grilldoo/diy-launch-monitor/docs/design.md

# Design

A battery-powered, photometric (camera-based) launch monitor in the style of the
Foresight GC3 / GCQuad. It sits beside the ball, photographs the last few
centimetres of club travel and the first ~30 cm of ball flight, and needs no
in-bay calibration, so it can be set up anywhere: hitting mat, garage, range.

Radar units (Trackman-style) were rejected because indoors they need a long
flight and placement calibration. Cameras only need to see the impact zone.

## Coordinate system and sign conventions

Origin at the ball centre at address. `+x` toward the target, `+y` up, `+z`
away from a right-handed golfer (toward the unit). Internally everything is SI
(m, s, rad); results are reported in golf units.

| Quantity | Positive means |
|---|---|
| HLA (horizontal launch) | right of target |
| VLA (vertical launch) | up |
| Sidespin / spin axis | curves right (fade/slice for a right-hander) |
| Club path | in-to-out (right) |
| Face to target | open (right) |
| Attack angle | up |
| Face to path | face - path |

## Layout

```
                 target (+x) -->
   golfer (RH)        o ball
   -z side     [gate2]  [gate1] are spots on the mat 18 and 30 cm behind the ball
                          \
                           \  ~60-70 cm
                            [ UNIT ]  +z side, ~35 cm forward of the ball,
                                       yawed back toward the impact zone
```

The unit sits forward of the ball and looks back diagonally so the cameras can see
the club-face stickers at an angle. (From straight side-on, the face is edge-on.)
Placement constants live in `src/launchmonitor/rig.py`; `tests/test_rig.py`
checks that every club and ball position the solver needs is in frame.

## Hardware architecture

```
 12 V Li-ion pack (BMS) -+-- 5V/5A buck --> Raspberry Pi 5 (4GB)  [+ 2nd Pi 5 in stage 2]
                        +-- 12V rail + capacitor bank --> LED driver --> 12x 850 nm IR LEDs
 Pi 5
  |- CSI0/CSI1 --> InnoMaker IMX296 mono global-shutter cameras, 850 nm bandpass filters
  |- USB ------> Pico 2: gates in, camera triggers + strobe out (microsecond timing)
  |- SPI ------> ADXL355 accelerometer (automatic level)
  `- Wi-Fi ----> GSPro (Open Connect, TCP 921) / phone web page
```

### Stages
* **Stage 1, 2 cameras:** one stereo pair (6 mm lenses, 20 cm baseline) sees club and ball.
* **Stage 2, 4 cameras (GCQuad-style):** add a second Pi 5 and a dedicated club pair
  (12 mm lenses, tighter view of the last 10 cm before impact). The Pico already has four
  camera trigger outputs, so all four cameras are hardware-synchronised.

### Why a strobe instead of a high-speed camera
The cameras are 60 fps global-shutter sensors (about $50). One exposure stays open for
~3-6 ms while the IR LEDs flash 15 µs pulses. Every flash freezes the ball and club
(80 m/s x 15 µs = 1.2 mm blur), so one frame holds the whole sequence.

## Timing (firmware/pico/src/lm_timing.c, mirrored in schedule.py)

1. **Club gates.** Two retro-reflective optical gates (IR emitter + photodiode in the unit,
   aimed at small retro-reflective dots on the mat at 30 cm and 18 cm behind the ball). The
   clubhead breaks each return beam in turn.
2. **Club speed and impact time** come from the gate-to-gate time. Impact is predicted
   assuming constant speed over the last 18 cm.
3. **Flash plan:**
   * 3 club flashes, when the face is 13, 7.5 and 2 cm from the ball. They're ~5.5 cm apart so
     the sticker images don't overlap in either camera, which sees them at a steep angle (even
     so, slow wedge swings can make two touch: the detector splits them). Face angle and loft
     come from the last one (the face is still closing before that). Path, attack angle and club
     speed come from all three.
   * 5 ball flashes, spaced so the ball moves about 6 cm (1.4 diameters) between them, based on
     *expected* ball speed (1.35 x club speed). Ball images never overlap, even at a smash
     factor of 1.15 (`tests/test_rig.py`).
   * Too-fast swings drop the earliest club flash rather than miss the shot.
4. **Exposure** opens 50 µs before the first flash and closes 50 µs after the last.
5. The Pico prints the actual schedule as JSON. The solver uses those times, so the
   impact-prediction error only shifts flash timing; it doesn't corrupt the measurement.

### Cameras and trigger
The cameras are **InnoMaker CAM-IMX296Mono-GS** boards: the same Sony IMX296 global-shutter
sensor as the official Pi GS camera, and the same Raspberry Pi kernel driver. The differences
that matter here:
* **Mono sensor with no IR-cut filter.** The official GS camera is colour with a fixed IR-cut
  filter, which blocks the 850 nm strobe.
* **Opto-isolated hardware trigger on a pin header (J3).** No board modification, unlike the
  official camera's XTR pad. Wiring is in docs/wiring.md.
* M12 lens mount (a CS seat is included). Lenses must not have an IR-cut filter.

The trigger opto adds a turn-off delay of up to tens of microseconds at exposure start, and it
varies between units. The schedule opens the exposure 300 µs before the first flash
(`exposure_lead_us`). The flashes, not the exposure edges, define when each image is taken, so
that delay doesn't affect the measurement. The first club flash comes 5 cm after gate 2, so it
fits at every club speed up to the 75 m/s (168 mph) limit.

## Optics and lighting
* IMX296: 1456 x 1088, 3.45 µm pixels. With a 6 mm M12 lens at ~65 cm the view is about 55 cm
  wide at 0.37 mm/px. A ball is about 115 px across.
* 850 nm bandpass filters reject most indoor light. Gate emitters are 940 nm, so the cameras
  don't see them.
* Outdoor kit (phase 6): swap to 940 nm LEDs and filters (the atmosphere absorbs some sunlight
  at 940 nm), add a sun hood and drive the LEDs harder. Gate emitters move to 850 nm with
  modulation.

## Markings
* **Ball:** 30 dots of 3.5 mm in an irregular pattern (`src/launchmonitor/data/ball_pattern.json`),
  applied with the 3D-printed jig (`cad/ball_jig.scad`) so every ball is identical. The pattern
  was chosen by `tools/make_ball_pattern.py`: of 12 random well-spaced candidates, it's the one
  whose orientation is recovered most reliably from only the dots two cameras can see (300 of
  300 trials). Dots stay 7° clear of the jig's seam. **Treat the pattern as fixed once balls are
  marked:** regenerating it makes every marked ball useless.
* **Ink:** must absorb IR. Use carbon-pigment ink (e.g. Sakura Pigma Micron). Many Sharpie inks
  are invisible at 850 nm, so test under the strobe first.
* **Club:** a 32 x 28.5 mm sticker with five 5 mm dots (`src/launchmonitor/markers.py`), on the
  face near the toe. The layout was searched so that no wrong labelling of the dots fits it
  under any stretch or skew the oblique camera view produces, with all dots or any one missing.
  The best wrong fit is 1.2 mm off. Distinct dot-to-dot distances alone weren't enough: an early
  layout had a re-ordering that fitted to 0.1 mm once stretched. Clubs **must** be marked for
  face angle and loft. Path and club speed need the sticker too, the way this detector works.

## Club detection (src/launchmonitor/detect.py)
Each frame holds the sticker three times before impact, plus more images after impact (the club
keeps moving and the ball flashes light it), some overlapping the ball images. Per camera:
1. **Balls first, robust to overlaps:** a distance transform finds each ball's centre (only a
   ball is that thick), and the circle is refitted on its own outline, ignoring attached sticker
   edges. The resting ball is the biggest saturated disk (every flash lit it). Moving-ball
   images are given flash numbers from their spacing, so a hidden image shows as a double gap
   instead of shifting the rest. Inconsistent spacing means that camera's ball data is dropped.
2. **Stickers:** bright regions left after masking the balls, containing 4-6 dark dots. Touching
   sticker images are split by clustering their dots.
3. **Which flash:** stickers *behind* the resting ball (opposite to the ball's flight) are the
   club before impact, nearest the ball = last club flash. The rest are ignored.
4. **Which dot:** every assignment is fitted with an affine map. Mirror images are skipped (the
   cameras only ever see the front), and the best fit must clearly beat the runner-up, or the
   sticker is dropped.
5. **3D check:** the triangulated dots must match the printed layout within 1.5 mm, or face
   angle and loft are not reported.

Over 90 random rendered shots (driver to wedge), no sticker was mislabelled. Club speed came
out within 0.05 mph rms, path 0.04°, attack 0.01°, face 0.25°, loft 0.25° (`tests/test_club.py`).
These are rendered frames without real-world glare, specular club heads or worn stickers, so
real numbers will be worse. The table below models detection noise.

## Ball-dot matching (src/launchmonitor/dots.py)
Image detection (`detect.detect_shot`) finds ball images and dark dots but doesn't know which
dot is which. For each ball flash:
1. Back-project every dot onto the ball sphere (centre triangulated from the ball images, known
   radius). This works from one camera, so dots only one camera sees still count.
2. Merge points from both cameras that land within 1.5 mm of each other.
3. Find the rotation of the known pattern that explains the points. A coarse search over 12,000
   rotations is followed by ICP on the best 8. The score also penalises pattern dots that face
   the cameras squarely but weren't detected, which removes look-alike orientations.
4. Give each detection the id of the nearest rotated pattern dot (within 8°).

On rendered frames (driver and wedge, pixels in), every dot was labelled correctly, and spin came
out within about 1% (`tests/test_dots.py`). It takes about 0.1-0.3 s per flash in Python on a
laptop; the Pi 5 will be slower. Vectorising or porting the coarse search is the obvious speed-up.

## Solver (src/launchmonitor/solver.py)
1. Triangulate every detection seen by 2 or more cameras in the same flash (N-view DLT).
2. Ball: straight-line fit of centres vs. flash time gives speed, VLA and HLA.
3. Spin: Kabsch rotation of the ball dots between consecutive flashes gives angular velocity.
   That is split into backspin and sidespin around the launch direction.
4. Club: fit the known sticker layout in the last pre-impact flash for face and loft. A line fit
   of the sticker centroid over the club flashes gives speed, path and attack angle.
5. Ball flight model (`flight.py`) gives carry for the stand-alone readout. GSPro does its own.

## Simulated accuracy (detection noise only)

`python tools/accuracy_study.py --seeds 200`, 0.15 px detection noise, 1 sigma:

| Shot | Rig | Ball mph | VLA | HLA | Spin % | Axis | Club mph | Path | Attack | Face | Loft |
|---|---|---|---|---|---|---|---|---|---|---|---|
| driver | 2-camera | 0.08 | 0.01 | 0.06 | 0.35 | 0.41 | 0.14 | 0.09 | 0.02 | 0.62 | 0.68 |
| driver | 4-camera | 0.08 | 0.01 | 0.06 | 0.35 | 0.41 | 0.04 | 0.03 | 0.01 | 0.20 | 0.23 |
| 7-iron | 2-camera | 0.06 | 0.01 | 0.07 | 0.11 | 0.13 | 0.09 | 0.09 | 0.02 | 0.59 | 0.63 |
| 7-iron | 4-camera | 0.06 | 0.01 | 0.07 | 0.11 | 0.13 | 0.03 | 0.03 | 0.01 | 0.21 | 0.22 |
| wedge | 2-camera | 0.05 | 0.02 | 0.09 | 0.14 | 0.13 | 0.09 | 0.09 | 0.02 | 0.71 | 0.64 |
| wedge | 4-camera | 0.05 | 0.02 | 0.09 | 0.14 | 0.13 | 0.03 | 0.03 | 0.01 | 0.27 | 0.24 |

These are lower bounds. Real error will be higher, mostly from calibration, lens distortion,
detection bias and timing jitter, none of which are modelled yet.
What the table does show: **the dedicated club pair cuts face and loft error about 3x.** Ball
data doesn't change, since stage 2 doesn't touch the ball cameras.

## Calibration and setup (src/launchmonitor/calibration.py)

**Once, at build time** (ChArUco board; details in docs/pi-setup.md). Everything rigid is
stored relative to the unit itself (camera A's frame):
1. Lens intrinsics and distortion, and camera B relative to camera A: the board waved in front.
2. **Reference edge:** one straight edge of the enclosure (with sight notches) defines "aim".
   The board stands upright, parallel to that edge, and the software records which way the edge
   points in camera coordinates.
3. **IMU alignment:** with the board left in place, the unit is tilted on shims 4 ways and the
   accelerometer read each time. A rotation fit (Kabsch) maps IMU axes to camera axes, and also
   absorbs the accelerometer's constant offset over the range of tilts captured.

**Every setup, no board:**
1. Place the unit about 60 cm from the ball (the resting ball only needs to be in view; its
   position is measured each shot, not assumed).
2. Line the reference edge up with the target line (an alignment stick against it, or sight down
   the notches). Indoors: square it to the screen.
3. Turn it on. The IMU gives "up"; aim is the edge's direction projected onto the level plane, so
   a sloping mat doesn't change the aim. The level is re-read every few seconds while idle, so a
   bumped unit corrects itself, and each saved shot records the level and aim it used.

Simulated (tests/test_calibration.py): with a deliberately crooked IMU mount (~30°), 0.006 g
offset and realistic noise, the level + aim frame came out within 0.05° on average (0.11° worst)
over 30 random setups tilted up to ±5°. Real-world aim accuracy will be dominated by how
carefully the edge is lined up: typically ±0.5-1°, the same as a GC3/GCQuad.

The simulation doesn't model the accelerometer's zero point drifting with temperature. That's
why the level sensor is an ADXL355 (0.15 mg/°C max, so under 0.2° over a 20 °C swing) rather
than a consumer IMU like the ICM-42688-P (up to ±1 mg/°C, so up to ~1°).

**Camera-agreement check:** every shot, the ball centres from both cameras are triangulated and
reprojected. A median error above 1.5 px adds a "re-run the calibration" warning. A camera
knocked by 0.4° trips it; a healthy rig reads well under 1 px. It can't see movement that keeps
the views consistent (along the epipolar lines), but catches most bumps.

`calib reaim` (board upright on the mat at the target line) remains as an optional precise aim
(`run --aim board`).

## Known risks / open questions
* **Dot matching on real images:** solved on simulated frames (above). Still unproven against
  real dimples, scuffs, logos, uneven hand-marked dots, and printed-jig tolerances. If the
  ball's logo shows up as false dots, raise the dot-size filter or mark balls with the logo
  under the jig's solid area. UNVERIFIED on hardware.
* **High-spin aliasing:** wedges at 10,000 rpm turn about 90° between flashes. That's fine, but
  close to the 180° limit at low ball speed. Could add one extra closely spaced flash pair.
* **Club and ball overlap at impact:** the last club flash is 2 cm before contact. Check on
  real frames that stickers aren't hidden by the ball (the simulator ray-tests this).
* **Driver/wood face curvature:** woods have a curved face (bulge), so a sticker on the toe side
  sits on a part of the face that points a few degrees more open than the centre (~3-4° on a
  driver). Irons are flat. Needs a per-club face-angle offset (a "club profile"), not yet built.
* **Shiny club heads:** a chrome head can throw bright specular glints. They have no dot pattern,
  so they shouldn't pass as stickers, but they could merge with a sticker image. UNVERIFIED.
* **Face closure:** the face keeps closing (roughly 0.5-1° at typical closure rates) between the last flash and impact. Correct it
  by extrapolating the face rotation from the three club flashes.
* **GSPro sign conventions:** verify on first hookup.
