grilldoo/diy-launch-monitor/cad/stl/camera_mount_ballA.stl

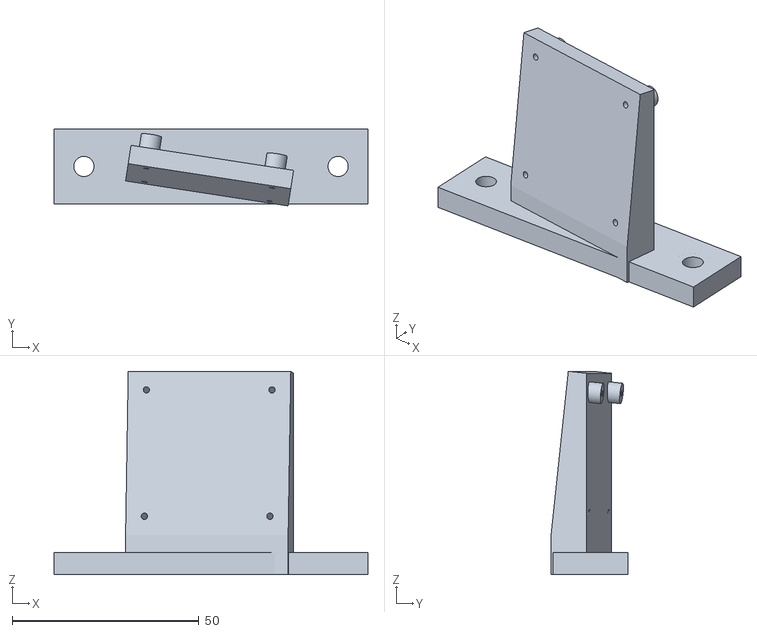
[picture p1: CAD file, 2026-10-27]
cad/stl/camera_mount_ballA.stl
84.0 x 20.6 x 54.4
