grilldoo/diy-launch-monitor/cad/stl/camera_mount_clubB.stl

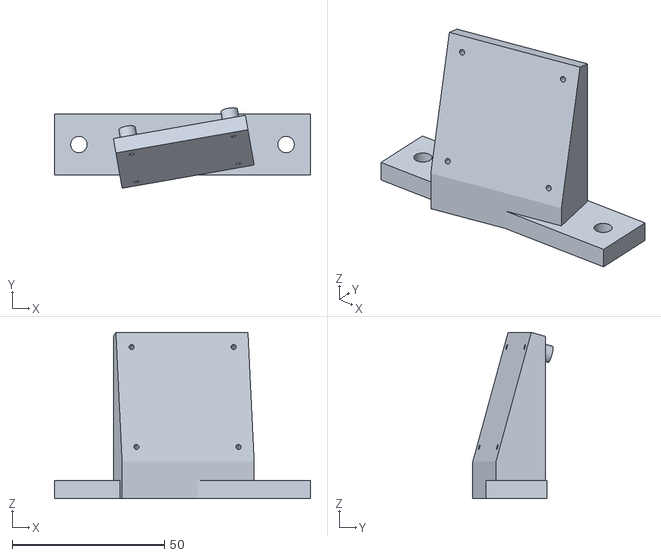
[picture p2: CAD file, 2026-10-27]
cad/stl/camera_mount_clubB.stl
84.0 x 26.4 x 54.5
