grilldoo/diy-launch-monitor/cad/stl/ball_jig_both_halves.stl

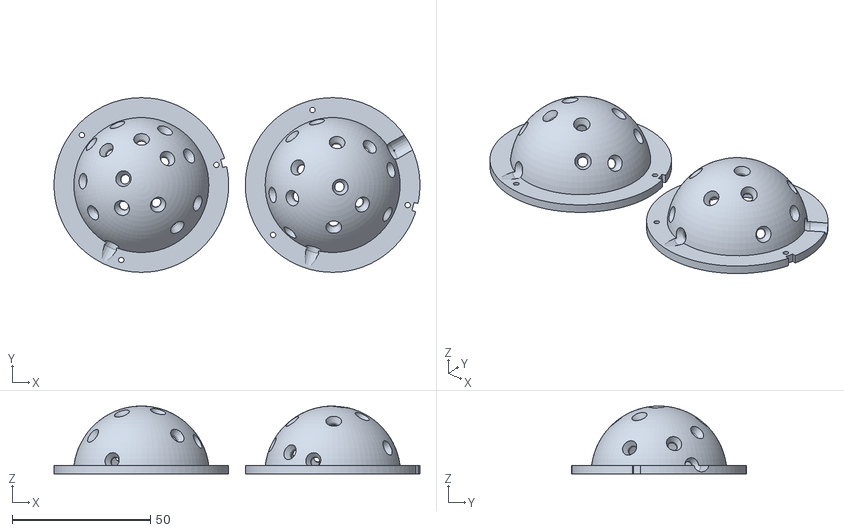
[picture p3: CAD file, 2026-10-26]
cad/stl/ball_jig_both_halves.stl
132.3 x 63.2 x 24.6
