grilldoo/diy-launch-monitor/cad/generated/ball_pattern.scad

// GENERATED by tools/export_cad.py - do not edit.
dot_diameter_mm = 3.5;
dots = [
  [0.003034, 0.676107, 0.736797],
  [-0.632398, 0.704156, -0.322856],
  [-0.715365, -0.411466, 0.564755],
  [0.112517, 0.031223, -0.993159],
  [0.439768, 0.289435, -0.850195],
  [-0.518673, 0.517838, 0.680310],
  [-0.287041, -0.341091, 0.895134],
  [-0.265278, 0.093471, 0.959631],
  [0.387106, 0.391987, 0.834563],
  [-0.888963, 0.146910, -0.433777],
  [-0.354678, 0.889289, 0.288736],
  [0.813491, 0.434916, -0.386109],
  [-0.234277, -0.932909, -0.273487],
  [-0.738997, 0.606211, 0.293926],
  [0.549815, -0.565982, -0.614303],
  [0.065977, -0.629361, -0.774307],
  [0.016566, 0.624239, -0.781058],
  [-0.599529, -0.719334, -0.350890],
  [-0.518569, -0.260606, -0.814353],
  [-0.865394, 0.057665, 0.497764],
  [0.833241, -0.270970, 0.481960],
  [0.865297, -0.485169, -0.125982],
  [0.532882, -0.628310, 0.566801],
  [0.707892, 0.431431, 0.559246],
  [-0.286326, 0.936851, -0.200819],
  [-0.433154, -0.878638, 0.200932],
  [0.248546, -0.292207, 0.923493],
  [0.864693, -0.223056, -0.450057],
  [-0.597028, 0.194788, -0.778213],
  [0.350280, 0.807965, 0.473810]
];
