grilldoo/diy-launch-monitor/cad/generated/rig_angles.scad

// GENERATED by tools/export_cad.py - do not edit.
// [name, yaw_deg (+ = counter-clockwise seen from above), pitch_deg (+ = up)]
// Mount the two cameras of a pair 200 mm apart (lens centre to lens centre).
cams = [
  ["ballA", -8.75, -6.08],
  ["ballB", 8.75, -6.08],
  ["clubA", -9.98, -15.50],
  ["clubB", 9.98, -15.50]
];
