grilldoo/diy-launch-monitor/(list of files, cad)

Other CAD files:
cad/stl/camera_mount_ballB.stl
cad/stl/camera_mount_clubA.stl
