grilldoo/diy-launch-monitor/docs/printing.md

# 3D printing (Bambu A1 Mini)

Ready-to-print files are in [`cad/stl/`](../cad/stl). They are generated from the OpenSCAD
sources in `cad/` by `python tools/export_cad.py`, using the same ball pattern, rig geometry and
club-marker layout that the solver assumes. Don't edit the STLs by hand: change the `.scad`
parameters or the Python geometry, then re-export. (Claude Code can do this for you.)

Filament: **PETG** for everything. It's stiffer under warmth than PLA and doesn't need an
enclosure like ASA. Defaults are fine unless noted.

| File | Qty | Stage | Settings |
|---|---|---|---|
| `ball_jig_both_halves.stl` | 1 | now | 0.12-0.16 mm layers, 3 walls, flange down, no supports |
| `camera_mount_ballA.stl`, `camera_mount_ballB.stl` | 1 each | 1 | 0.2 mm, 4 walls, 40% infill, foot down, no supports |
| `camera_mount_clubA.stl`, `camera_mount_clubB.stl` | 1 each | 2 | as above |
| `../club_markers.svg` | sheet | 1 | paper, not 3D: print at 100% on matte white sticker paper |

The enclosure and battery box come later, once the boards and pack are in hand to measure.
The enclosure will have a straight **reference edge** with a sight notch at each end: lining
that edge up with the target line is how the unit is aimed at each setup (docs/design.md).

## Ball-marking jig

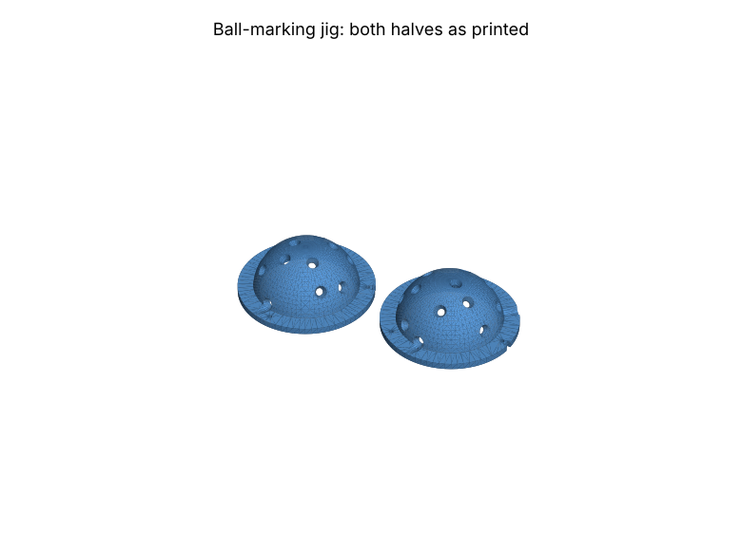
[picture p4: docs/images/ball_jig.png]
Ball-marking jig


Two half-shells with a countersunk hole at every pattern dot (30 dots, 3.5 mm).

1. **Test the fit first.** The ball should drop in snugly and not turn once the halves are closed.
   If it's loose or won't close, change `clearance` in `cad/ball_jig.scad` (default 0.25 mm,
   radial) and re-export.
2. **Pins:** cut three ~6 mm pieces of 1.75 mm filament. The three pin holes are unevenly
   spaced, so the halves only line up one way. The notches on the flange edges should line up
   too. If PETG prints the holes tight, open them with a 2 mm drill bit by hand.
3. Close the jig around a clean ball. Turn the ball so its logo sits under solid shell, not a
   hole, before closing.
4. Mark through every hole with a **Sakura Pigma Micron 05 (or 08)**: a firm, circular motion
   fills the 3.5 mm hole. Do all 30 dots (15 per half) without opening the jig.
5. Let it dry for a minute before opening.
6. **IR check (once you have the camera and LEDs):** the dots must look black under 850 nm. If
   they fade, switch pens.

Every ball must use **this exact pattern**. `src/launchmonitor/data/ball_pattern.json` is now
fixed, so don't regenerate it.

## Camera mounts

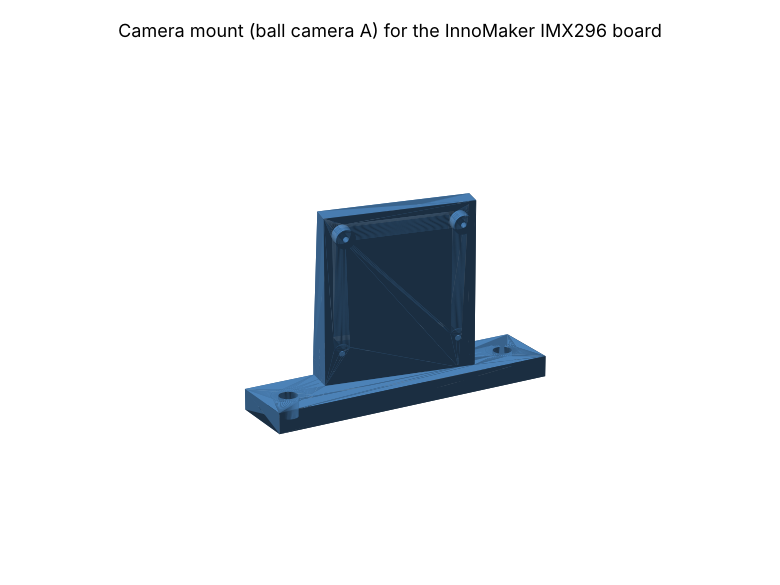
[picture p5: docs/images/camera_mount.png]
Camera mount


* For the **InnoMaker CAM-IMX296Mono-GS** board: 39 x 39 mm, four holes on a 34 mm square.
* Bolts to the top of a 2020 extrusion with 2x M5x10 screws and 2020 T-nuts. The screws sit
  outside the plate, so you can reach them with the camera fitted.
* The board screws onto the four bosses with **4x M2x8 self-tapping screws**, lens facing away
  from the plate. The bosses hold the board 4 mm off the plate to clear the parts on its back.
  Put the 15-pin ribbon connector at the top.
* Pre-angled from the rig geometry:

  | Mount | Yaw (toe-in) | Pitch |
  |---|---|---|
  | ballA / ballB | -8.7° / +8.7° | -6.1° (down) |
  | clubA / clubB | -10.0° / +10.0° | -15.5° (down) |

* Space the two cameras of a pair **200 mm apart** (lens centre to lens centre). Camera A is
  the left one when you stand behind the unit facing the ball.
* Stereo calibration measures the exact pose, so a degree or so of error is fine. Once
  calibrated, the cameras must not move: add a drop of medium thread-locker on the M5s.
* UNVERIFIED: InnoMaker's manual doesn't give the board's hole diameter (M2 fits either M2 or
  M2.5 holes). Hold a board against the print before printing the second one.
* The 850 nm filter cap that fits over the M12 lens comes later, once the lens is in hand to
  measure.

## Club markers

Every club you want club data from needs one. `cad/club_markers.svg` has 16 stickers
(32 x 28.5 mm, five 5 mm dots). Print at 100% on matte white sticker paper and check the
50 mm bar.

* Stick it **flat on the face, on the toe side**, arrow toward the toe, inner edge about 3.5 mm
  toe-side of the face centre (the middle of the grooves). It must sit flat: lay it across the
  grooves, not into them.
* Rotation doesn't matter: face angle comes from the sticker's tilt, not which way it's turned.
* **Don't mirror it.** The sheet is printed as the face looks from the front (from the
  target), toe on the left, for right-handed clubs. Don't print it with "mirror" or "flip" on.
* Matte paper, not glossy: a shiny sticker throws glare under the flash.
* The dots must be black under 850 nm. Laser toner and most inkjet black inks are; check one
  under the strobe.
* Replace stickers when the edges lift or the white scuffs.
