grilldoo/diy-launch-monitor/(commit log)

2026-10-26 Initial launch monitor scaffold: simulator, solver, Pico timing firmware, docs
    - Python package: camera model + N-view triangulation, 2/4-camera rigs,
    synthetic shot generator and IR frame renderer, ball detection, solver for
    ball launch, spin (Kabsch on marked-ball dots) and club face/path, ball
    flight model, GSPro Open Connect client
    - Pico 2 firmware: club-gate trigger, impact prediction, strobe/exposure
    schedule (host-testable, mirrored in Python with a parity test)
    - Accuracy study comparing 2- and 4-camera rigs
    - Design, BOM and wiring docs; CI for Python, host C tests and firmware build
    Claude-Session: https://claude.ai/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
2026-10-26 CI: use prebuilt ARM toolchain for the firmware build
    Claude-Session: https://claude.ai/code/session_01Amzq2eoKChySZn9cE8tGz9
2026-10-26 Ball-dot matching, image detection pipeline, and printable parts
    - dots.py: label unlabeled dot detections by back-projecting onto the ball
    sphere and fitting the known pattern's orientation (coarse rotation search
    + ICP, penalising predicted-but-missing dots)
    - Fixed 30-dot irregular ball pattern (data/ball_pattern.json), chosen by
    tools/make_ball_pattern.py for unambiguous matching
    - detect.py: dot detection and detect_shot() turning multi-exposure frames
    into observations; renderer now ray-traces the sphere so dots foreshorten
    - End-to-end test: rendered frames -> detection -> matching -> solver
    - cad/: OpenSCAD ball-marking jig and 2020 camera mounts (angles from the rig),
    gene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
    [ball_jig.scad, ball_jig_both_halves.stl, ball_pattern.scad, camera_mount.scad, camera_mount_ballA.stl, camera_mount_ballB.stl, camera_mount_clubA.stl, camera_mount_clubB.stl]
2026-10-27 Switch to InnoMaker CAM-IMX296Mono-GS cameras
    The official Pi GS camera is colour with a fixed IR-cut filter, which blocks
    the 850 nm strobe. InnoMaker's mono IMX296 board has no IR-cut filter and an
    opto-isolated trigger input on a header (J3), so no board mod is needed.
    - Timing: separate exposure_lead_us (300 us) so the trigger opto's turn-off
    delay can't start the exposure after the first flash (C + Python mirror)
    - Firmware/wiring: cameras triggered through a ULN2003A (opto LED lit while
    idle, falling edge starts exposure); InnoMaker trigger/I2C setup documented
    - Camera mount redesigned for the 39 mm board (34 mm hole square, M2 screws)
    - BOM: InnoMaker cameras, M12 lenses without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
    [camera_mount.scad, camera_mount_ballA.stl, camera_mount_ballB.stl, camera_mount_clubA.stl, camera_mount_clubB.stl]
2026-10-27 Pi capture, ChArUco stereo calibration, and the GSPro main loop
    - capture.py: picamera2 capture of InnoMaker IMX296 cameras in external-
    trigger mode (long libcamera timeout), frame pairing by sensor timestamp
    - imx296.py: trigger-mode register writes over I2C (InnoMaker sequence)
    - calibration.py: ChArUco board, intrinsics + lens distortion, stereo, and
    world frame from an upright aim board; reaim after moving the unit;
    printable board page
    - Camera model gains lens distortion; detections are undistorted before
    triangulation; the renderer now draws through lens distortion
    - pipeline.py / app.py: Pico report -> frames -> detect/match/solve -> GSPro,
    every shot saved for replay; GSP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
2026-10-27 Board-free setup: IMU auto-level, reference-edge aim, camera-agreement check
    The ChArUco board is now a build-time tool only. Calibration is stored relative
    to the unit (camera A's frame); each setup gets its world frame from the IMU
    (up) and the enclosure's reference edge (aim), re-read while idle.
    - calibration.py: UnitCalibration; reference-edge and IMU-to-camera alignment
    calibrated from an upright board with the unit tilted on shims (Kabsch fit,
    absorbs accelerometer offset); optional board aim kept as
    - imu.py: ICM-42688 driver (I2C) + simulated IMU; i2c.py shared I2C access
    - pipeline: per-shot stereo reprojection check warns if a camera has moved
    - app/CLI: live level correction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
    [__main__.py, app.py, calibration.py, i2c.py, imu.py, imx296.py, models.py, pipeline.py]
2026-10-27 Club tracking from pixels: face-sticker detection, labelling and checks
    Club speed, path, attack angle, face angle and loft now come from the camera
    frames (face sticker), not just from simulated detections.
    - markers.py: one sticker definition (5 x 5 mm dots, 32 x 28.5 mm) shared by
    the printable sheet, simulator, detector and solver. Layout searched so no
    wrong labelling fits under any affine (oblique) view, all dots or one missing
    - detect.py: distance-transform ball detection that survives the club's
    post-impact sticker images overlapping balls; resting ball from its
    saturated core; flash numbers from image spacing (a hidden image shows as
    a double gap); sticker regions, dot c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
    [detect.py, lm_timing.c, markers.py, schedule.py, sim.py, solver.py]
2026-10-27 Test club detection from pixels on the 4-camera rig too
    The simulated launch monitor now renders every camera in the rig, not just
    the ball pair, and the club-from-pixels tests run on both the 2- and
    4-camera rigs (tighter face tolerance for the dedicated club pair).
    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
    [sim_source.py]
2026-10-28 Sourced bill of materials; ADXL355 level sensor
    - docs/bom.md rewritten with specific models, sources and October 2026
    prices (seen vs typical marked), how each part fits the build, and budget
    swaps. Notable changes: Pi 5 4 GB (2026 RAM price rises), Commonlands
    no-IR-filter M12 lenses and thin 850 nm bandpass discs that fit inside the
    lens holder, pre-wired OSLON Black 850 nm LED modules (no reflow), a
    TalentCell 12 V pack with protection and charger, Pololu regulators
    - Level sensor switched to the ADXL355 (EVAL-ADXL355-PMDZ, SPI): 0.15 mg/degC
    max zero drift vs up to 1 mg/degC for the ICM-42688-P, which could cost up to
    ~1 deg of launch angle between a cold and a warm sessio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
    [__main__.py, imu.py]
